commanderk9826/KDL/README.md

국민대학교 24EV KUST 데이터로거팀

KUST Data Logger 제작 프로젝트
참여자 : 이채훈, 옹미령, 강호, 이지규

PCB제작 : 고민제
