commanderk9826/KDL/device/hardware(TMA-1)/TMA-1.kicad_pcb

## KiCad design device/hardware(TMA-1)/TMA-1.kicad_pcb (2024-03-19)

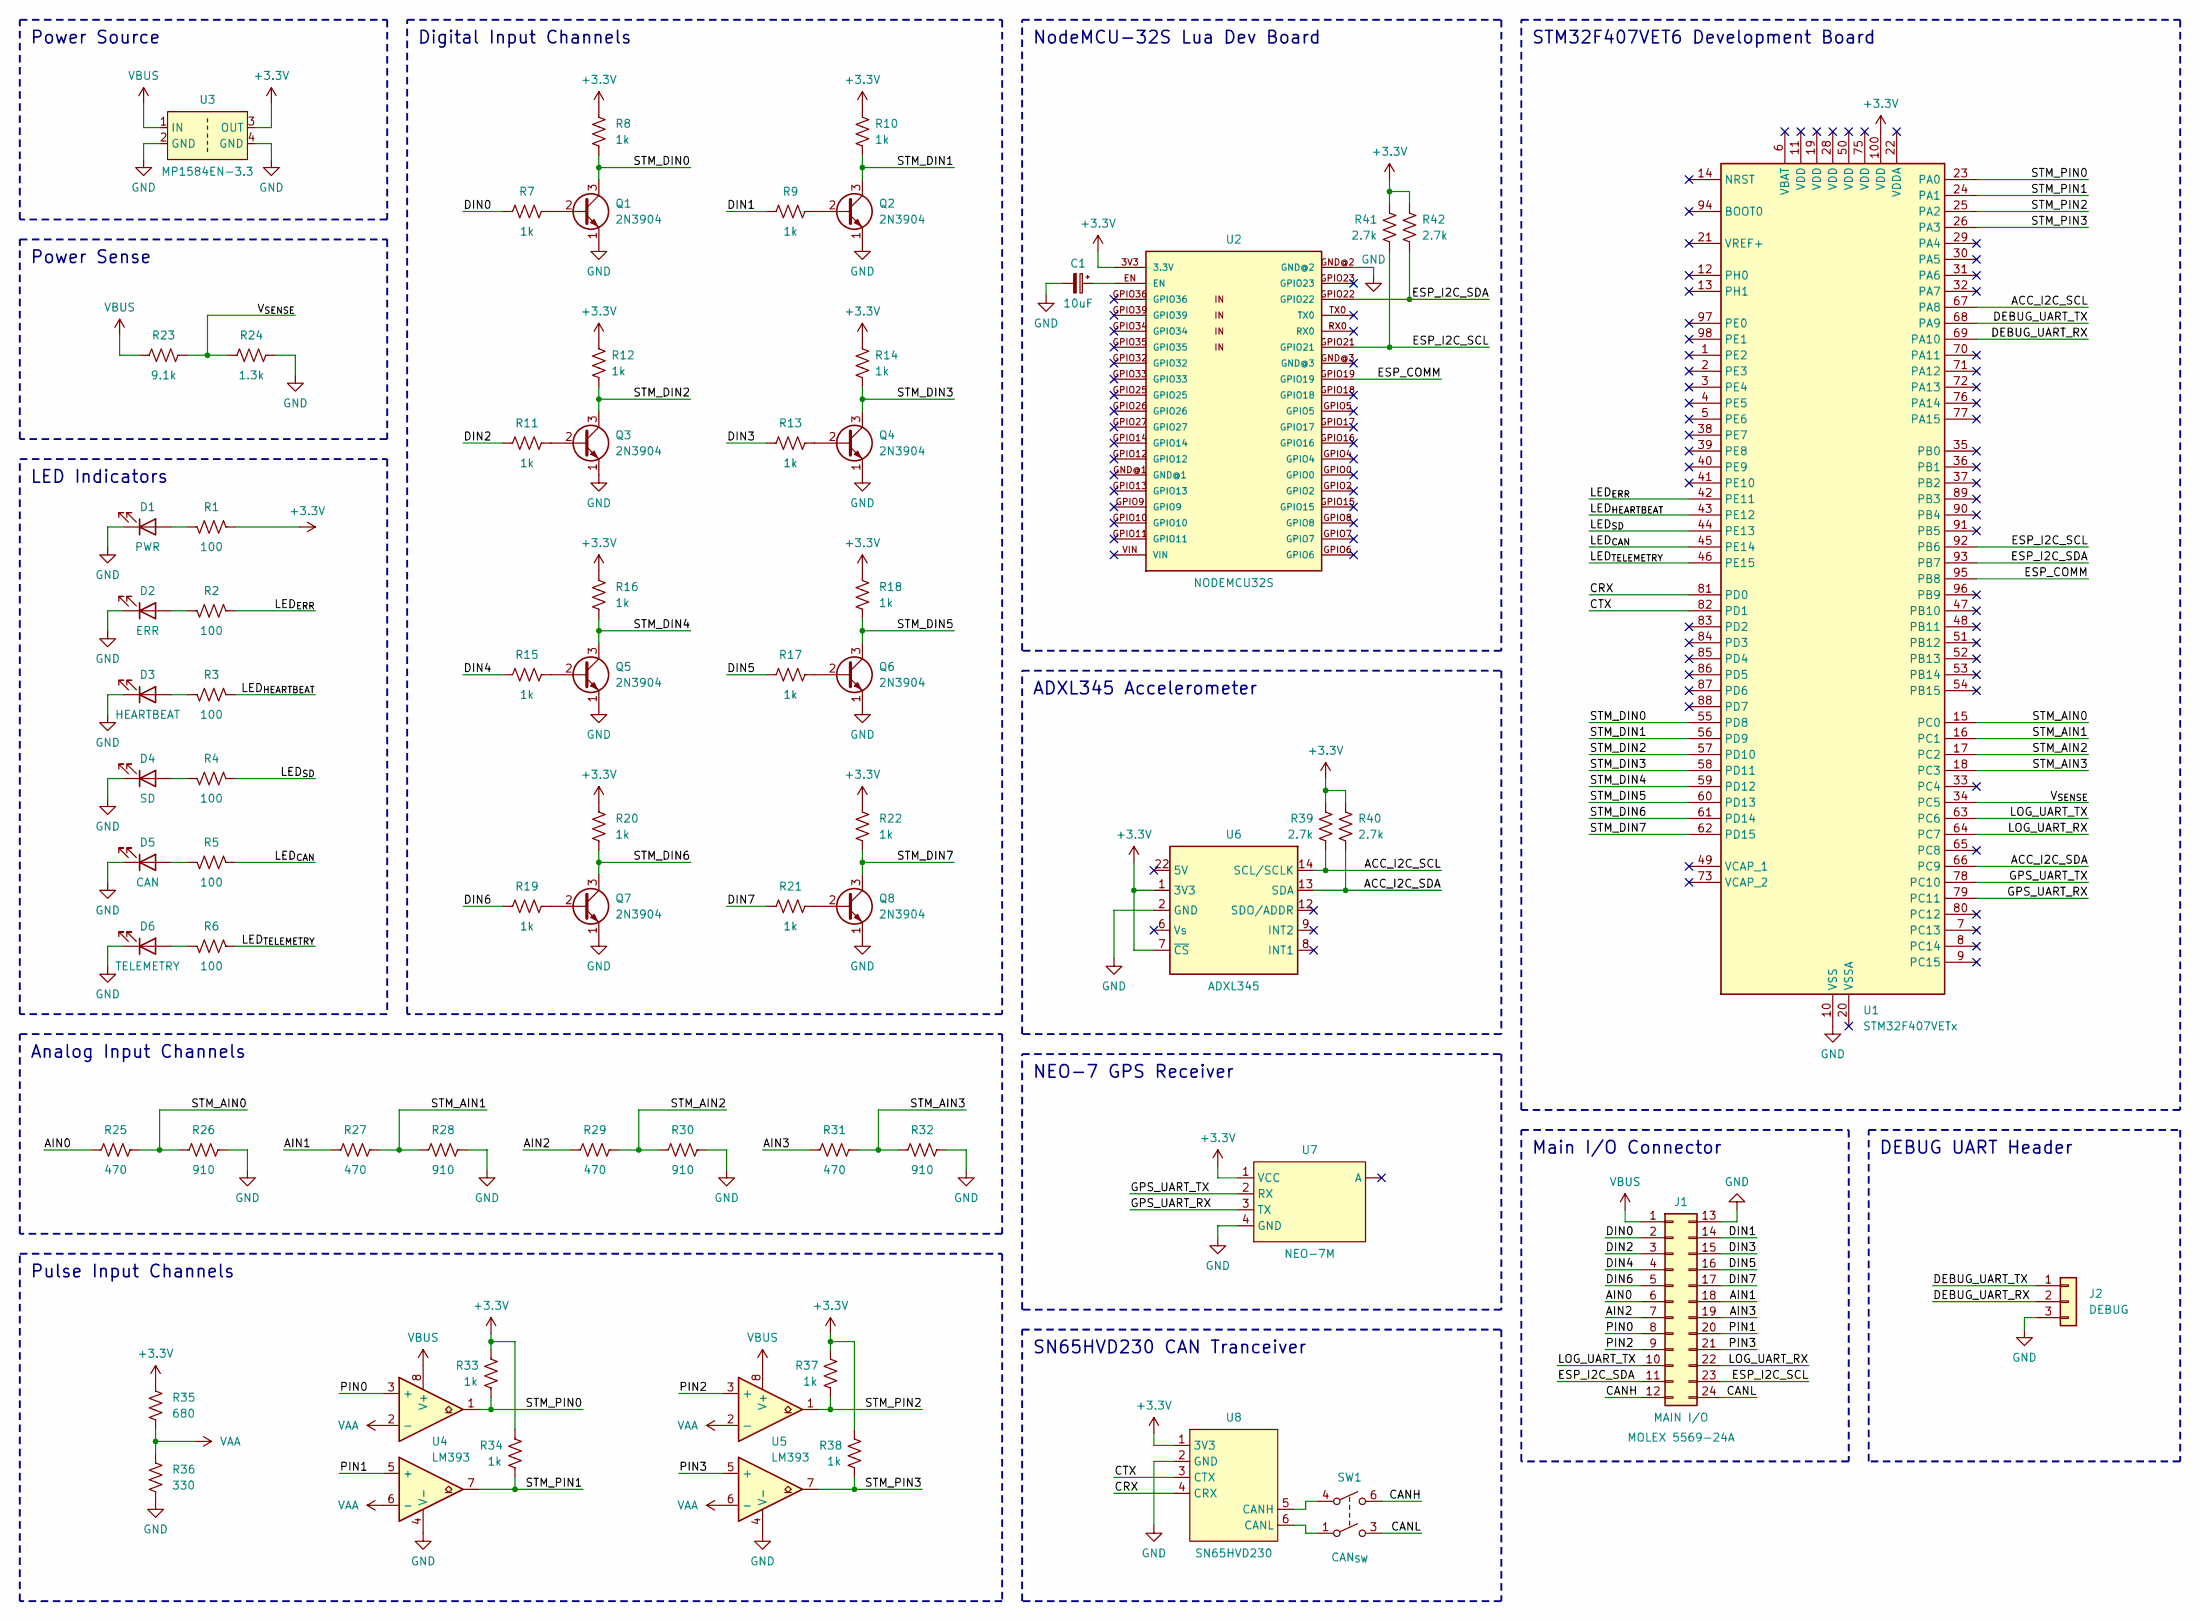
[picture p1: schematic TMA-1.kicad_sch]

Parts:
C1: 10uF; CP_Radial_D5.0mm_P2.00mm
D1: PWR; LED_D5.0mm_FlatTop
D2: ERR; LED_D5.0mm_FlatTop
D3: HEARTBEAT; LED_D5.0mm_FlatTop
D4: SD; LED_D5.0mm_FlatTop
D5: CAN; LED_D5.0mm_FlatTop
D6: TELEMETRY; LED_D5.0mm_FlatTop
J1: MAIN I/O; Molex_Mini-Fit_Jr_5569-24A1_2x12_P4.20mm_Horizontal
J2: DEBUG; PinHeader_1x03_P2.54mm_Vertical
Q1, Q2, Q3, Q4, Q5, Q6, Q7, Q8: 2N3904; TO-92_Inline_Wide
R1, R2, R3, R4, R5, R6: 100; R_Axial_DIN0207_L6.3mm_D2.5mm_P10.16mm_Horizontal
R7, R8, R9, R10, R11, R12, R13, R14, R15, R16, R17, R18, R19, R20, R21, R22, R33, R34, R37, R38: 1k; R_Axial_DIN0207_L6.3mm_D2.5mm_P10.16mm_Horizontal
R23: 9.1k; R_Axial_DIN0207_L6.3mm_D2.5mm_P10.16mm_Horizontal
R24: 1.3k; R_Axial_DIN0207_L6.3mm_D2.5mm_P10.16mm_Horizontal
R25, R27, R29, R31: 470; R_Axial_DIN0207_L6.3mm_D2.5mm_P10.16mm_Horizontal
R26, R28, R30, R32: 910; R_Axial_DIN0207_L6.3mm_D2.5mm_P10.16mm_Horizontal
R35: 680; R_Axial_DIN0207_L6.3mm_D2.5mm_P10.16mm_Horizontal
R36: 330; R_Axial_DIN0207_L6.3mm_D2.5mm_P10.16mm_Horizontal
R39, R40, R41, R42: 2.7k; R_Axial_DIN0207_L6.3mm_D2.5mm_P10.16mm_Horizontal
SW1: CAN_{SW}; TOGGLE_SWITCH
U1: STM32F407VETx; STM32F407_HOLDER
U2: NODEMCU32S
U3: MP1584EN-3.3; MP1584EN_MODULE
U4, U5: LM393; DIP-8_W7.62mm
U6: ADXL345; ADXL345_MODULE
U7: NEO-7M; GPS_MODULE
U8: SN65HVD230; SN65HVD230_MODULE

Connections:
+3.3V: R1.1, R8.1, R10.1, R12.1, R14.1, R16.1, R18.1, R20.1, R22.1, R33.1, R34.1, R35.1, R37.1, R38.1, R39.1, R40.1, R41.1, R42.1, U1.100 (VDD), U2.3V3 (3.3V), U3.3 (OUT), U6.1 (3V3), U6.7 (~CS), U7.1 (VCC), U8.1 (3V3)
/ACC_I2C_SCL: R39.2, U1.67 (PA8), U6.14 (SCL/SCLK)
/ACC_I2C_SDA: R40.2, U1.66 (PC9), U6.13 (SDA)
/AIN0: J1.6, R25.1
/AIN1: J1.18, R27.1
/AIN2: J1.7, R29.1
/AIN3: J1.19, R31.1
/CANH: J1.12, SW1.6
/CANL: J1.24, SW1.3
/CRX: U1.81 (PD0), U8.4 (CRX)
/CTX: U1.82 (PD1), U8.3 (CTX)
/DEBUG_UART_RX: J2.2, U1.69 (PA10)
/DEBUG_UART_TX: J2.1, U1.68 (PA9)
/DIN0: J1.2, R7.1
/DIN1: J1.14, R9.1
/DIN2: J1.3, R11.1
/DIN3: J1.15, R13.1
/DIN4: J1.4, R15.1
/DIN5: J1.16, R17.1
/DIN6: J1.5, R19.1
/DIN7: J1.17, R21.1
/ESP_COMM: U1.95 (PB8), U2.GPIO19
/ESP_I2C_SCL: J1.23, R41.2, U1.92 (PB6), U2.GPIO21
/ESP_I2C_SDA: J1.11, R42.2, U1.93 (PB7), U2.GPIO22
/GPS_UART_RX: U1.79 (PC11), U7.3 (TX)
/GPS_UART_TX: U1.78 (PC10), U7.2 (RX)
/LED_{CAN}: R5.1, U1.45 (PE14)
/LED_{ERR}: R2.1, U1.42 (PE11)
/LED_{HEARTBEAT}: R3.1, U1.43 (PE12)
/LED_{SD}: R4.1, U1.44 (PE13)
/LED_{TELEMETRY}: R6.1, U1.46 (PE15)
/LOG_UART_RX: J1.22, U1.64 (PC7)
/LOG_UART_TX: J1.10, U1.63 (PC6)
/PIN0: J1.8, U4.3 (+)
/PIN1: J1.20, U4.5 (+)
/PIN2: J1.9, U5.3 (+)
/PIN3: J1.21, U5.5 (+)
/STM_AIN0: R25.2, R26.1, U1.15 (PC0)
/STM_AIN1: R27.2, R28.1, U1.16 (PC1)
/STM_AIN2: R29.2, R30.1, U1.17 (PC2)
/STM_AIN3: R31.2, R32.1, U1.18 (PC3)
/STM_DIN0: Q1.3 (C), R8.2, U1.55 (PD8)
/STM_DIN1: Q2.3 (C), R10.2, U1.56 (PD9)
/STM_DIN2: Q3.3 (C), R12.2, U1.57 (PD10)
/STM_DIN3: Q4.3 (C), R14.2, U1.58 (PD11)
/STM_DIN4: Q5.3 (C), R16.2, U1.59 (PD12)
/STM_DIN5: Q6.3 (C), R18.2, U1.60 (PD13)
/STM_DIN6: Q7.3 (C), R20.2, U1.61 (PD14)
/STM_DIN7: Q8.3 (C), R22.2, U1.62 (PD15)
/STM_PIN0: R33.2, U1.23 (PA0), U4.1
/STM_PIN1: R34.2, U1.24 (PA1), U4.7
/STM_PIN2: R37.2, U1.25 (PA2), U5.1
/STM_PIN3: R38.2, U1.26 (PA3), U5.7
/V_{SENSE}: R23.2, R24.1, U1.34 (PC5)
GND: C1.2, D1.1 (K), D2.1 (K), D3.1 (K), D4.1 (K), D5.1 (K), D6.1 (K), J1.13, J2.3, Q1.1 (E), Q2.1 (E), Q3.1 (E), Q4.1 (E), Q5.1 (E), Q6.1 (E), Q7.1 (E), Q8.1 (E), R24.2, R26.2, R28.2, R30.2, R32.2, R36.2, U1.10 (VSS), U1.27 (VSS), U1.74 (VSS), U1.99 (VSS), U2.GND@2, U3.2 (GND), U3.4 (GND), U4.4 (V-), U5.4 (V-), U6.2 (GND), U7.4 (GND), U8.2 (GND)
unnamed: C1.1, U2.EN
unnamed: D1.2 (A), R1.2
unnamed: D2.2 (A), R2.2
unnamed: D3.2 (A), R3.2
unnamed: D4.2 (A), R4.2
unnamed: D5.2 (A), R5.2
unnamed: D6.2 (A), R6.2
unnamed: Q1.2 (B), R7.2
unnamed: Q2.2 (B), R9.2
unnamed: Q3.2 (B), R11.2
unnamed: Q4.2 (B), R13.2
unnamed: Q5.2 (B), R15.2
unnamed: Q6.2 (B), R17.2
unnamed: Q7.2 (B), R19.2
unnamed: Q8.2 (B), R21.2
unnamed: SW1.4, U8.5 (CANH)
unnamed: SW1.1, U8.6 (CANL)
VAA: R35.2, R36.1, U4.2 (-), U4.6 (-), U5.2 (-), U5.6 (-)
VBUS: J1.1, R23.1, U3.1 (IN), U4.8 (V+), U5.8 (V+)

Notes on the sheet:
LED Indicators
Power Source
Main I/O Connector
Digital Input Channels
STM32F407VET6 Development Board
DEBUG UART Header
NEO-7 GPS Receiver
Power Sense
Analog Input Channels
Pulse Input Channels
ADXL345 Accelerometer
SN65HVD230 CAN Tranceiver
NodeMCU-32S Lua Dev Board

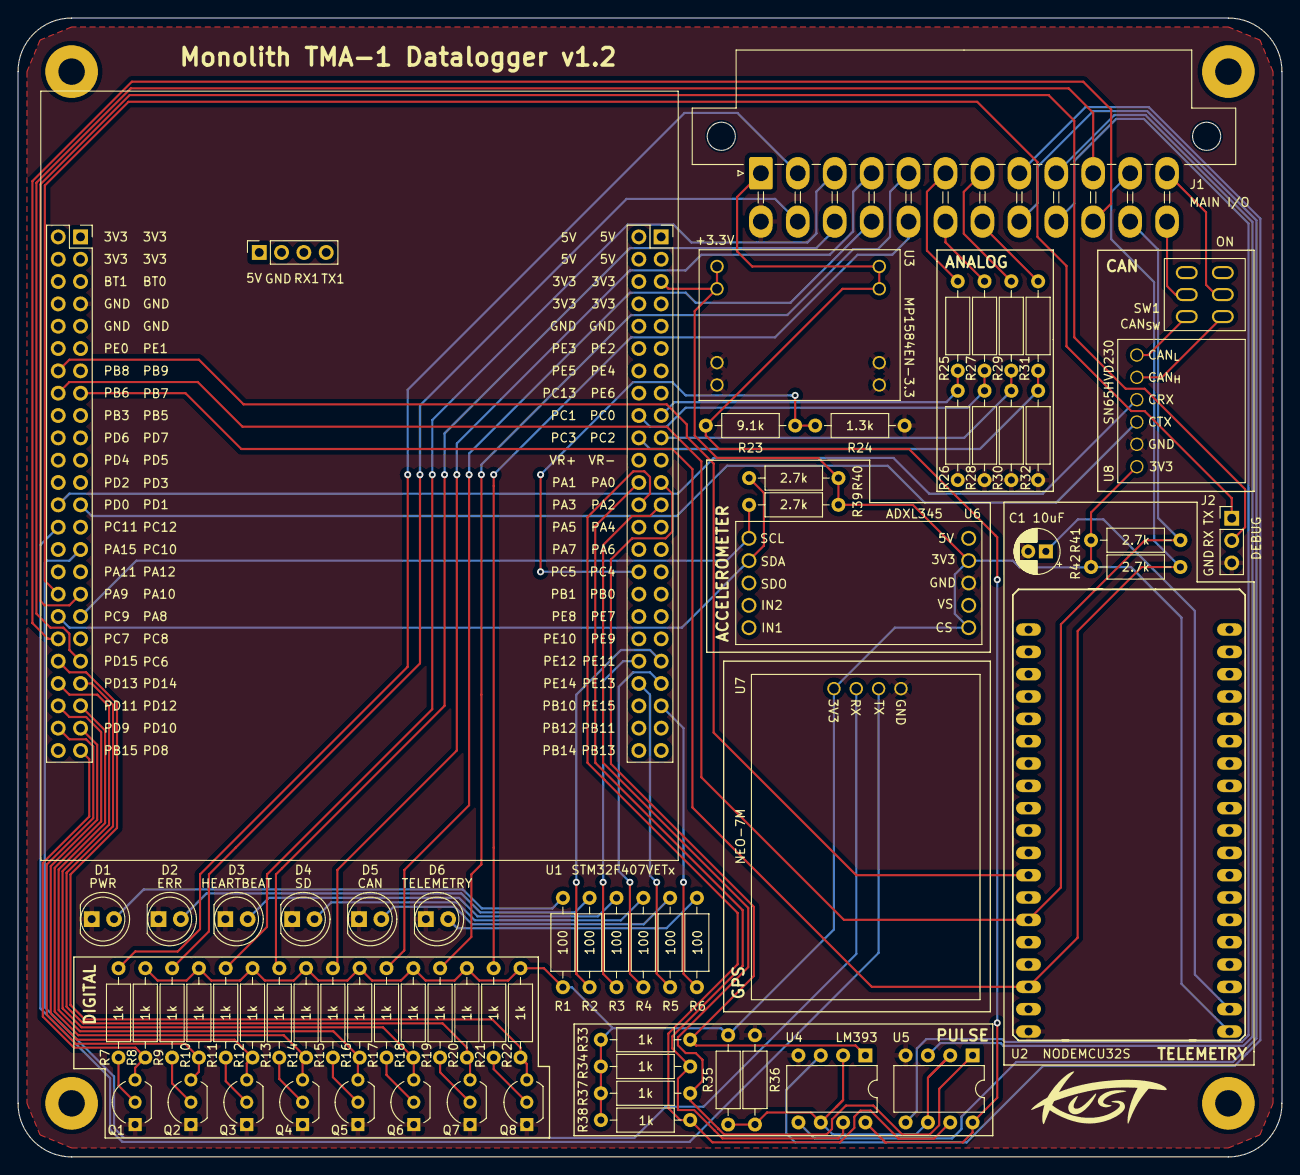
[picture p2: board TMA-1.kicad_pcb from above]

Board: 2 copper layers, 143.8 x 129.5 mm, 68 parts (0 on the bottom side), 74 nets.
