commanderk9826/KDL/device/hardware(KDL)/KDL.kicad_pcb

## KiCad design device/hardware(KDL)/KDL.kicad_pcb (2024-03-19)

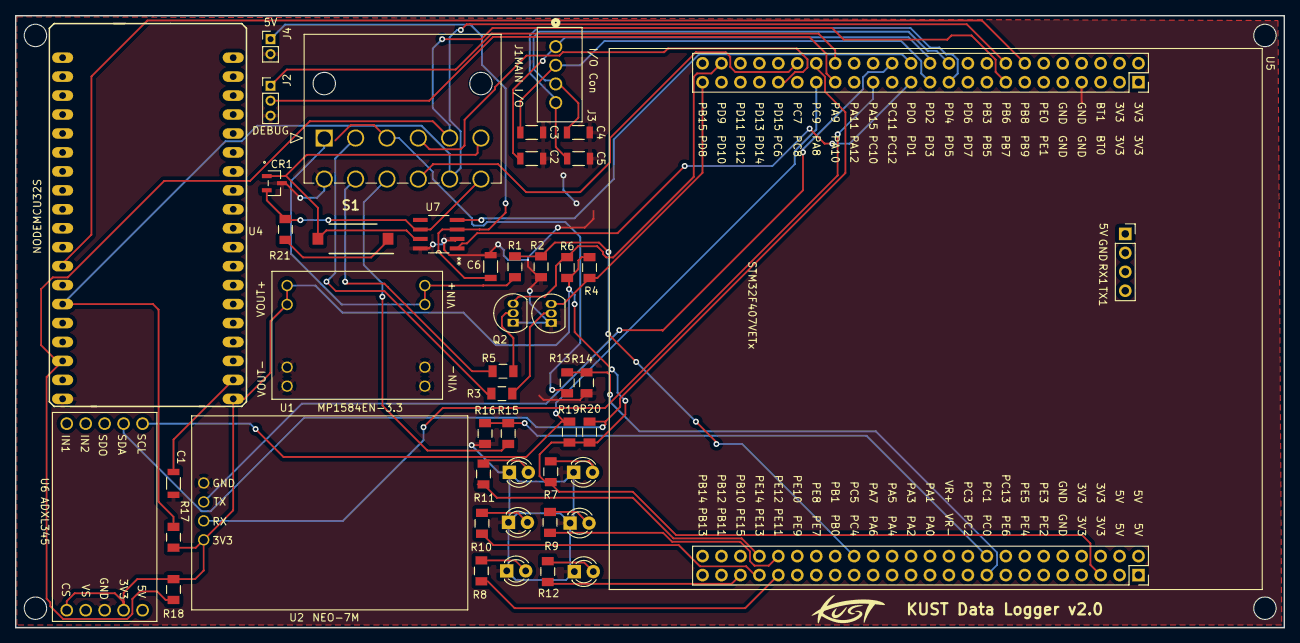
[picture p3: board KDL.kicad_pcb from above]

Board: 2 copper layers, 170.0 x 82.0 mm, 47 parts (0 on the bottom side), 47 nets.

Parts:
C1: 10uF; CAP_CL31_SAM
C2, C3, C4, C5: 1uF; CAP_CL31_SAM
C6: 0.1uF; CAP_CL31_SAM
CR1: CDSOT23-T24CAN; SOT23-3L_STM
D1: PWR; LED_D3.0mm
D2: ERR; LED_D3.0mm
D3: HEARTBEAT; LED_D3.0mm
D4: SD; LED_D3.0mm
D5: CAN; LED_D3.0mm
D6: TELEMETRY; LED_D3.0mm
J1: MAIN I/O; CON_39301121
J2: DEBUG; PinHeader_1x03_P2.00mm_Vertical
J3: I/O Con; CONN_B4B-XH-A_JST
J4: 5V; PinHeader_1x02_P2.00mm_Vertical
Q1, Q2: 2N3904; TO-92_Inline
R1: 9.1k; RC1206N_YAG
R2: 1.3k; RC1206N_YAG
R3, R4, R5, R6: 1k; RC1206N_YAG
R7, R8, R9, R10, R11, R12: 220; RC1206N_YAG
R13, R15: 470; RC1206N_YAG
R14, R16: 910; RC1206N_YAG
R17, R18: 2.7k; RC1206N_YAG
R19, R20: 2.7K; RC1206N_YAG
R21: 120k; RC1206N_YAG
S1: CFS-0102MB; SOD10040X470N
U1: MP1584EN-3.3; MP1584EN_MODULE
U2: NEO-7M; GPS_MODULE
U4: NODEMCU32S
U5: STM32F407VETx; STM32F407_HOLDER
U6: ADXL345; ADXL345_MODULE
U7: SN65HVD1050DR; D8

Connections:
+3.3V: R4.1, R6.1, R7.2, R17.1, R18.1, R19.2, R20.2, U1.3 (OUT), U2.1 (VCC), U4.3V3 (3.3V), U5.100 (VDD), U6.1 (3V3), U6.7 (~CS)
/5V: C6.2, J4.1, U7.3 (VCC)
/ACC_I2C_SCL: R19.1, U5.67 (PA8), U6.14 (SCL/SCLK)
/ACC_I2C_SDA: R20.1, U5.66 (PC9), U6.13 (SDA)
/AIN0: J1.3, R13.1
/AIN1: J1.9, R15.1
/CANH: CR1.1, J1.6, S1.2, U7.7 (CANH)
/CANL: CR1.2, J1.12, R21.1, U7.6 (CANL)
/CRX: U5.81 (PD0), U7.4 (RXD)
/CTX: U5.82 (PD1), U7.1 (TXD)
/DEBUG_UART_RX: J2.2, U5.69 (PA10)
/DEBUG_UART_TX: J2.1, U5.68 (PA9)
/DIN0: J1.2, R3.2
/DIN1: J1.8, R5.2
/ESP_COMM: U4.GPIO19, U5.95 (PB8)
/ESP_I2C_SCL: J1.11, R17.2, U4.GPIO21, U5.92 (PB6)
/ESP_I2C_SDA: J1.5, R18.2, U4.GPIO22, U5.93 (PB7)
/GPS_UART_RX: U2.3 (TX), U5.79 (PC11)
/GPS_UART_TX: U2.2 (RX), U5.78 (PC10)
/IO1: C2.2, J3.1, U5.83 (PD2)
/IO2: C3.2, J3.2, U5.84 (PD3)
/IO3: C4.2, J3.3, U5.85 (PD4)
/IO4: C5.2, J3.4, U5.86 (PD5)
/LED_CAN: R11.2, U5.45 (PE14)
/LED_ERR: R8.2, U5.42 (PE11)
/LED_HEARTBEAT: R9.2, U5.43 (PE12)
/LED_SD: R10.2, U5.44 (PE13)
/LED_TELEMETRY: R12.2, U5.46 (PE15)
/LOG_UART_RX: J1.10, U5.64 (PC7)
/LOG_UART_TX: J1.4, U5.63 (PC6)
/STM_AIN0: R13.2, R14.1, U5.15 (PC0)
/STM_AIN1: R15.2, R16.1, U5.16 (PC1)
/STM_DIN0: Q1.3 (C), R4.2, U5.55 (PD8)
/STM_DIN1: Q2.3 (C), R6.2, U5.56 (PD9)
/VSENSE: R1.2, R2.1, U5.34 (PC5)
GND: C1.1, C2.1, C3.1, C4.1, C5.1, C6.1, CR1.3, D1.1 (K), D2.1 (K), D3.1 (K), D4.1 (K), D5.1 (K), D6.1 (K), J1.7, J2.3, J4.2, Q1.1 (E), Q2.1 (E), R2.2, R14.2, R16.2, U1.2 (GND), U1.4 (GND), U2.4 (GND), U4.GND@2, U5.10 (VSS), U6.2 (GND), U7.2 (GND), U7.8 (S)
unnamed: C1.2, U4.EN
unnamed: D1.2 (A), R7.1
unnamed: D2.2 (A), R8.1
unnamed: D3.2 (A), R9.1
unnamed: D4.2 (A), R10.1
unnamed: D5.2 (A), R11.1
unnamed: D6.2 (A), R12.1
unnamed: Q1.2 (B), R3.1
unnamed: Q2.2 (B), R5.1
unnamed: R21.2, S1.1
VBUS: J1.1, R1.1, U1.1 (IN)
