commanderk9826/KDL/device/TMA-1/TMA-1.ioc

Mcu.UserName=STM32F407VETx
PA0-WKUP.GPIO_Label=PIN0
PA0-WKUP.Signal=S_TIM5_CH1
PA1.GPIO_Label=PIN1
PA1.Signal=S_TIM5_CH2
PA10.GPIO_Label=USART_DEBUG_RX
PA10.Signal=USART1_RX
PA2.GPIO_Label=PIN2
PA2.Signal=S_TIM5_CH3
PA3.GPIO_Label=PIN3
PA3.Signal=S_TIM5_CH4
PA6.GPIO_Label=LED_ONBOARD_0
PA6.Signal=GPIO_Output
PA7.GPIO_Label=LED_ONBOARD_1
PA7.Signal=GPIO_Output
PA8.GPIO_Label=I2C_ACC_SCL
PA8.Signal=I2C3_SCL
PA9.GPIO_Label=USART_DEBUG_TX
PA9.Signal=USART1_TX
PB12.GPIO_Label=SDIO_DETECT
PB12.Signal=GPIO_Input
PB6.GPIO_Label=I2C_ESP_SCL
PB6.Signal=I2C1_SCL
PB7.GPIO_Label=I2C_ESP_SDA
PB7.Signal=I2C1_SDA
PB8.GPIO_Label=ESP_COMM
PB8.Signal=GPXTI8
PC0.GPIO_Label=AIN0
PC0.Signal=ADCx_IN10
PC1.GPIO_Label=AIN1
PC1.Signal=ADCx_IN11
PC10.GPIO_Label=USART_GPS_TX
PC10.Signal=USART3_TX
PC11.GPIO_Label=USART_GPS_RX
PC11.Signal=USART3_RX
PC12.Signal=SDIO_CK
PC14-OSC32_IN.Signal=RCC_OSC32_IN
PC15-OSC32_OUT.Signal=RCC_OSC32_OUT
PC2.GPIO_Label=AIN2
PC2.Signal=ADCx_IN12
PC3.GPIO_Label=AIN3
PC3.Signal=ADCx_IN13
PC5.GPIO_Label=Vsense
PC5.Signal=ADCx_IN15
PC6.GPIO_Label=USART_LOG_TX
PC6.Signal=USART6_TX
PC7.GPIO_Label=USART_LOG_RX
PC7.Signal=USART6_RX
PC8.Signal=SDIO_D0
PC9.GPIO_Label=I2C_ACC_SDA
PC9.Signal=I2C3_SDA
PD0.Signal=CAN1_RX
PD1.Signal=CAN1_TX
PD10.GPIO_Label=DIN2
PD10.Signal=GPIO_Input
PD11.GPIO_Label=DIN3
PD11.Signal=GPIO_Input
PD12.GPIO_Label=DIN4
PD12.Signal=GPIO_Input
PD13.GPIO_Label=DIN5
PD13.Signal=GPIO_Input
PD14.GPIO_Label=DIN6
PD14.Signal=GPIO_Input
PD15.GPIO_Label=DIN7
PD15.Signal=GPIO_Input
PD2.Signal=SDIO_CMD
PD8.GPIO_Label=DIN0
PD8.Signal=GPIO_Input
PD9.GPIO_Label=DIN1
PD9.Signal=GPIO_Input
PE10.GPIO_Label=LED_CUSTOM_1
PE10.Signal=GPIO_Output
PE11.GPIO_Label=LED_ERR
PE11.Signal=GPIO_Output
PE12.GPIO_Label=LED_HEARTBEAT
PE12.Signal=GPIO_Output
PE13.GPIO_Label=LED_SD
PE13.Signal=GPIO_Output
PE14.GPIO_Label=LED_CAN
PE14.Signal=GPIO_Output
PE15.GPIO_Label=LED_TELEMETRY
PE15.Signal=GPIO_Output
PE9.GPIO_Label=LED_CUSTOM_0
PE9.Signal=GPIO_Output
PH0-OSC_IN.Signal=RCC_OSC_IN
PH1-OSC_OUT.Signal=RCC_OSC_OUT
